jjflash65/pfs154_textdisplay_adapter/doku/impulsdiagram_8_bit.gif

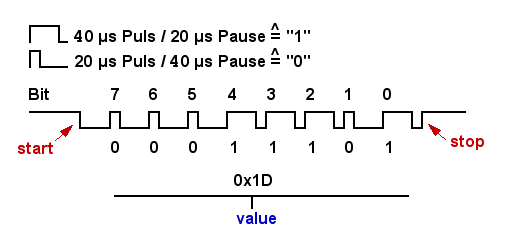
doku/impulsdiagram_8_bit.gif
