jjflash65/pfs154_textdisplay_adapter/doku/impulsdiagram_12_bit.gif

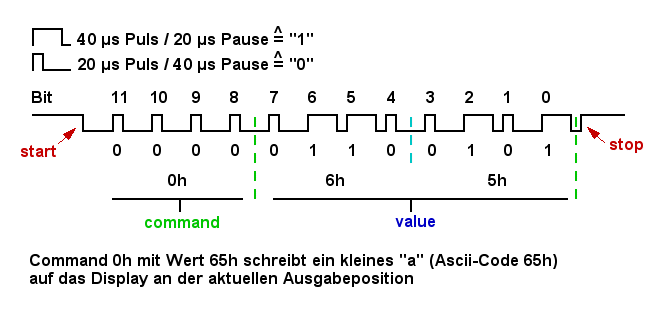
doku/impulsdiagram_12_bit.gif
