jjflash65/pfs154_textdisplay_adapter/doku/pfs_textlcd_adapter_v2.gif

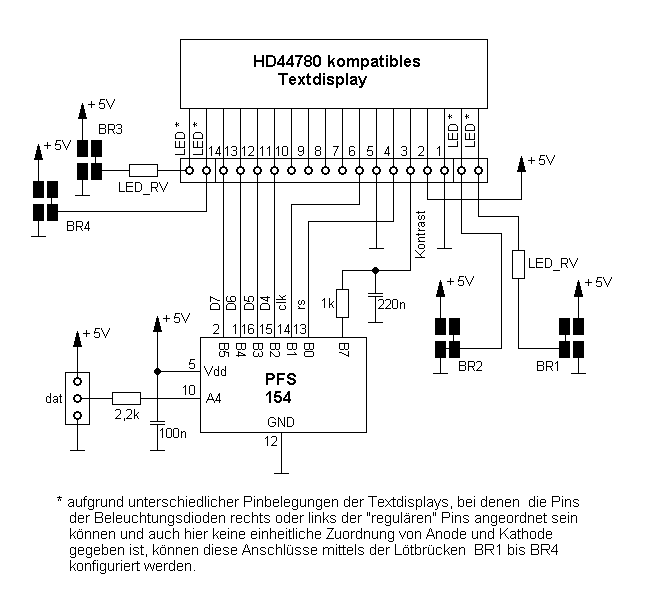
doku/pfs_textlcd_adapter_v2.gif
