jjflash65/pfs154_textdisplay_adapter/pfs154/stxlcd_recv_uart/include/uart_2.h

/* ------------------------------------------------------
                          uart_2.h

     Header fuer Softwaremodul einer Bitbanging er-
     zeugten seriellen Schnittstelle

     Compiler  : SDCC 4.0.3
     MCU       : PFS154 / PFS173

     hier verfuegbare Stringausgabe  kann mittels
     Wertzuweisung an

                    uart_puts_enable

     an- bzw. abgeschaltet werden. Immer dann
     empfehlenswert wenn der Speicherplatz knapp wird !!

     06.10.2020        R. Seelig

  ------------------------------------------------------- */

#ifndef in_uart_2
  #define in_uart_2

  #include <pdk/device.h>
  #include "pfs1xx_gpio.h"

  #define uart_puts_enable  0                // 0 : nicht verfuegbar
                                             // 1 : verfuegbar

  #define transmit_enable   0                // Sendenfunktion einbinden / nicht einbinden
  #define receive_enable    1                // Emfpangsfunktion einbinden / nicht einbinden

  #define uart_txbit        PA6              // Anschlusspin der TX-Leitung
  #define uart_rxbit        PA4              // Anschlusspin der RX-Leitung

  /* ---------------------------------------------------------------------------
                                 Baudratentabelle

      Die Implementierung der seriellen Schnittstelle auf dem PFS154 wird
      mittels Bitbanging realisiert. Anstelle eine sehr grosse Macro-Kette
      im Quellcode zu haben gibt es hier eine Tabelle fuer die Konstante
      uart_delfak, die die Baudrate der Schnittstelle fuer unterschiedliche
      Coretakte einstellt (Werte wurden impirisch mittels Logicanalyzer er-
      mitteln):

                           Werte fuer uart_delfak

      F_CPU   | 2400 Bd | 4800 Bd | 9600 Bd | 19200 Bd | 38400 Bd |  57600 Bd | 115200 Bd |
      -------------------------------------------------------------------------------------
         8    |   182   |   88    |   44    |    22    |    10    |     6     |
        16    |         |  182    |   88    |    44    |    22    |    14     |     6
  */

//  #define uart_delfak     6              // 57600 Bd [F_CPU== 8 MHz]
//  #define uart_delfak    22              // 19200 Bd [F_CPU== 8 MHz]
  #define uart_delfak    44               // 9600 Bd [F_CPU== 8 MHz]


  /* --------------------------------------------------
                       Prototypen
     -------------------------------------------------- */

  void uart_init(void);
  void uart_putchar (char c);
  char uart_getchar(void);
  void uart_puts(char *p);


  // ----------------------------------------------------------------
  // Praeprozessormacros um 2 Stringtexte zur weiteren Verwendung
  // innerhalb des Praeprozessors  zu verknuepfen
  //
  // Bsp.:
  //        #define ionr      3
  //        #define ioport    conc2(PA, ionr)
  //
  //        ioport wird nun als "PA3" behandelt
  #define CONC2EXP(a,b)     a ## b
  #define conc2(a,b)        CONC2EXP(a, b)
  // ----------------------------------------------------------------

  // define-Stringtexte der Anschlusspins erzeugen

  #define uarttx_set()    conc2(uart_txbit,_set())
  #define uarttx_clr()    conc2(uart_txbit,_clr())
  #define uarttx_init()   { conc2(uart_txbit,_output_init()); uarttx_set(); }

  #define uartrx_init()   conc2(uart_rxbit,_input_init())
  #define is_uartrx()     conc2(is_,uart_rxbit())

#endif
