jjflash65/pfs154_textdisplay_adapter/stm8_pwm/include/stxlcd.h

/* ---------------------------------------------------------
                         stxlcd.h

     Header Softwaremodul zum Ansprechen eines ueber einen
     Padauk PFS154 Controller gesteuerten Textdisplays
     mittels einer single-wire Verbindung.

     Datenleitung: PA3 (aenderbar)

     MCU      : STM8Sx003 / 105
     Compiler : SDCC 4.01 oder neuer

     zusaetzliche Hardware:
        PFS154 - Textdisplay

     19.10.2024   R. Seelig
   --------------------------------------------------------- */

#ifndef in_pfslcd
  #define in_pfslcd

  #include <stdint.h>
  #include <stdarg.h>
  #include <stdint.h>

  #include "stm8s.h"
  #include "stm8_init.h"
  #include "stm8_gpio.h"

  extern uint8_t wherex, wherey;

  #define enable_stxt_printf       1

  #if (enable_stxt_printf == 1)
    extern char printfkomma;
  #endif


  /* --------------------------------------------------
       Pinanschluss, auf dem der PFS-Textdisplay-
       adapter angesteuert wird
     -------------------------------------------------- */

  #define stxt_init()   PA3_output_init()
  #define stx_set()     PA3_set()
  #define stx_clr()     PA3_clr()

  /* --------------------------------------------------
     Pulslaenge und -dauer in Mikrosekunden deklarieren
     -------------------------------------------------- */

  #define pulselength    70
  #define pulsepause     20

  /* --------------------------------------------------
       Prototypen
     -------------------------------------------------- */

  void stxt_putchar(uint8_t ch);
  void stxt_sendval(uint16_t val);
  void stxt_senduserchar(uint8_t nr, const uint8_t *userch);
  void gotoxy(uint8_t x, uint8_t y);
  void stxt_printf(const uint8_t *s,...);

  /* --------------------------------------------------
       Kommandomakros
     -------------------------------------------------- */

  #define stxt_clrscr()             { stxt_sendval(0x200); delay(100); gotoxy(1,1); }
  #define stxt_shiftleft(anz)       stxt_sendval(0x500 | anz)
  #define stxt_shiftright(anz)      stxt_sendval(0x600 | anz)
  #define stxt_addch(ch, pos)       { stxt_sendval(0x300 | (ch << 3) | pos); delay(4); }
  #define stxt_contrast(val)         stxt_sendval(0x700 | val)


#endif
